maplac/StringLights/Electronics/doc_string_lights_revA/image_bottom.jpg

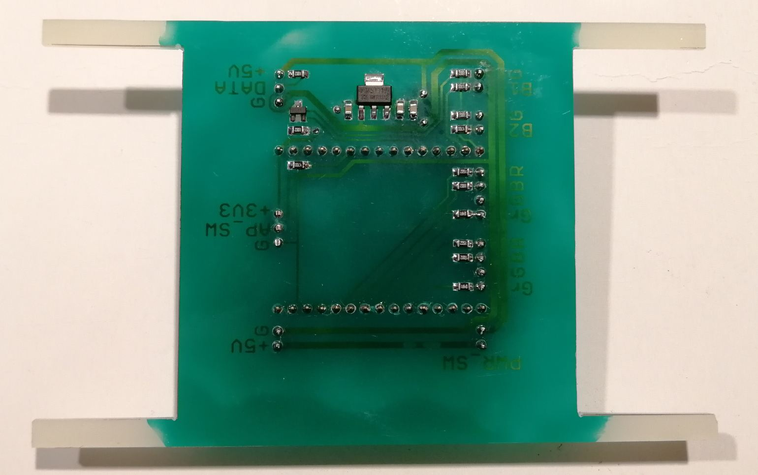
Electronics/doc_string_lights_revA/image_bottom.jpg
