maplac/StringLights/Electronics/doc_string_lights_revA/image_box_back.jpg

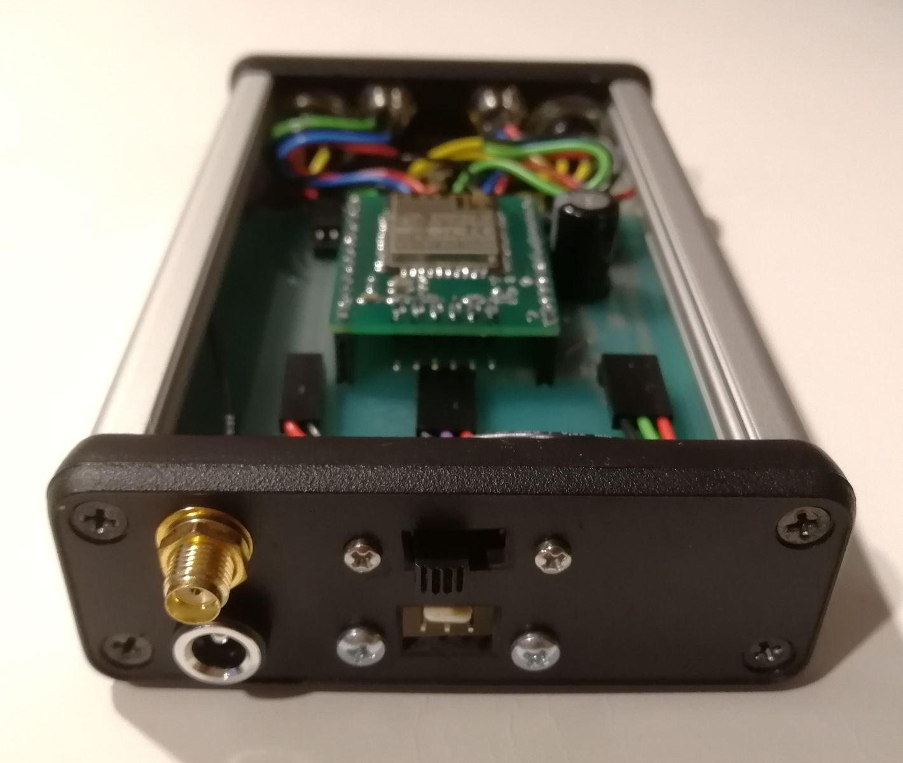
Electronics/doc_string_lights_revA/image_box_back.jpg
