maplac/StringLights/Electronics/doc_ESP32_adapter_revB/image_bottom.jpg

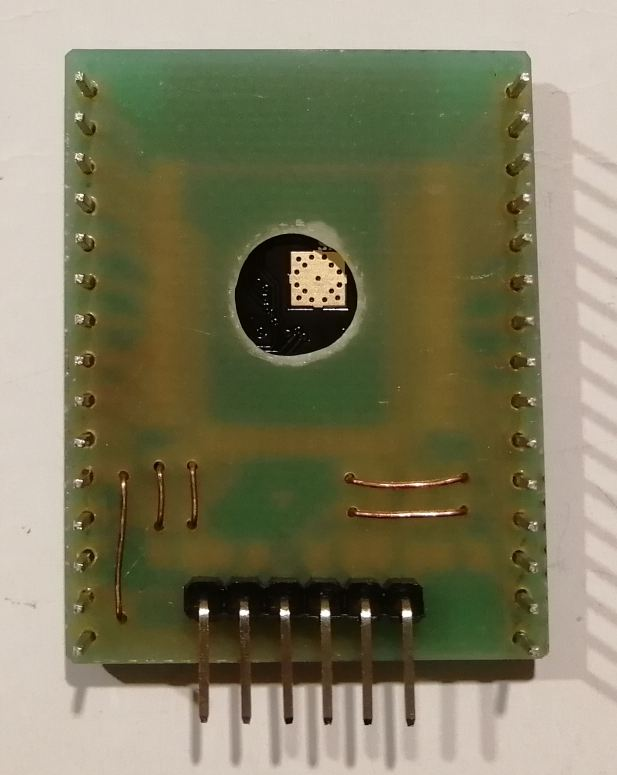
Electronics/doc_ESP32_adapter_revB/image_bottom.jpg
