maplac/StringLights/Electronics/doc_ESP32_adapter_revB/image_top.jpg

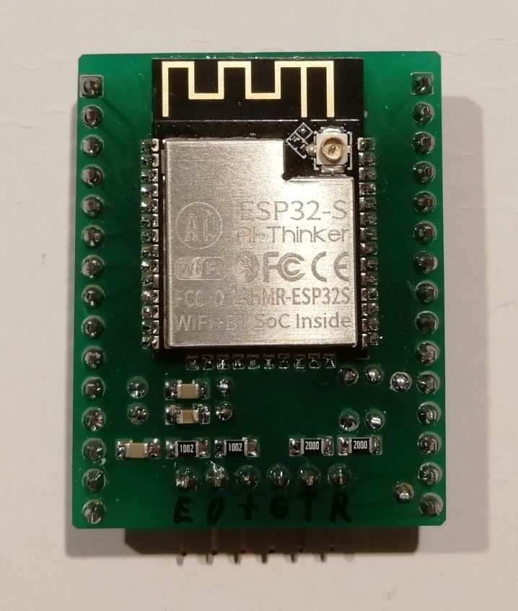
Electronics/doc_ESP32_adapter_revB/image_top.jpg
