maplac/StringLights/Electronics/doc_ESP32_programmer_revA/image_top.jpg

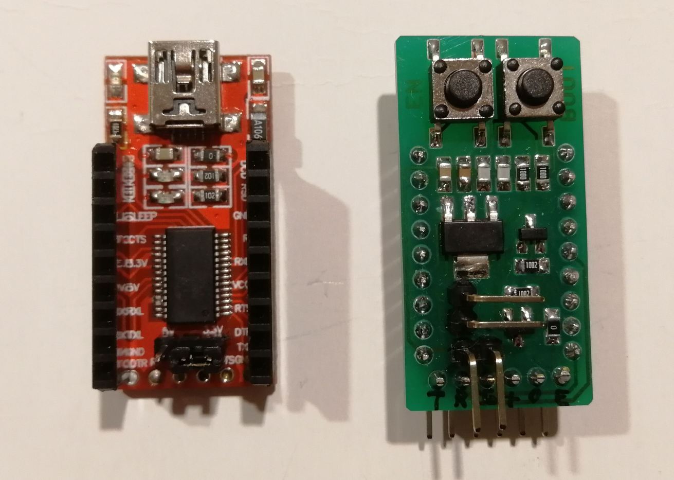
Electronics/doc_ESP32_programmer_revA/image_top.jpg
