maplac/StringLights/Electronics/doc_ESP32_programmer_revA/mask.png

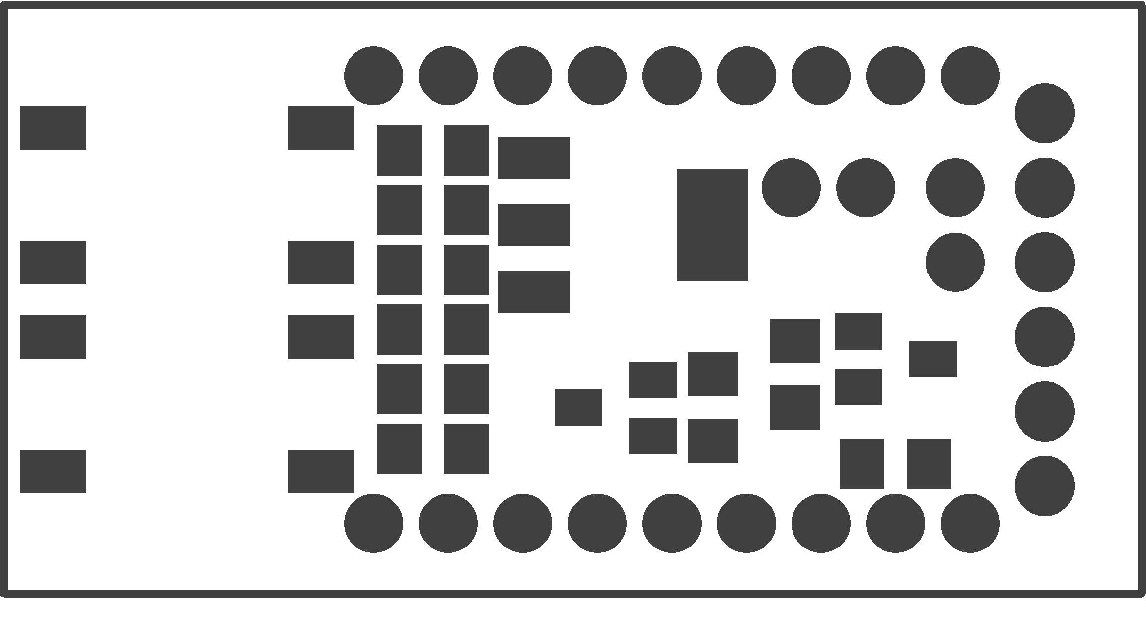
Electronics/doc_ESP32_programmer_revA/mask.png
