maplac/StringLights/Electronics/doc_ESP32_programmer_revA/names.png

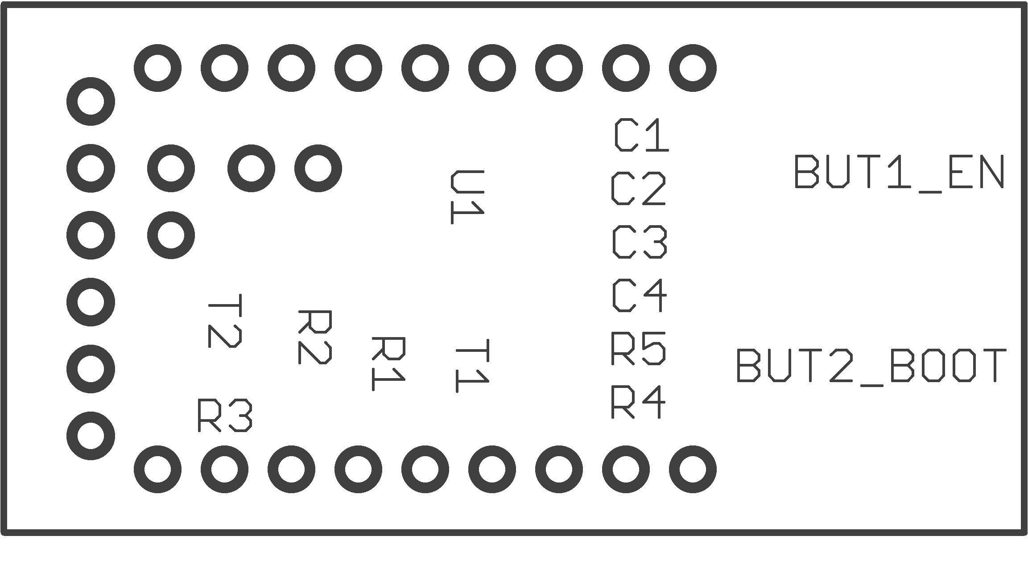
Electronics/doc_ESP32_programmer_revA/names.png
