maplac/StringLights/Electronics/doc_ESP32_programmer_revA/schematics.png

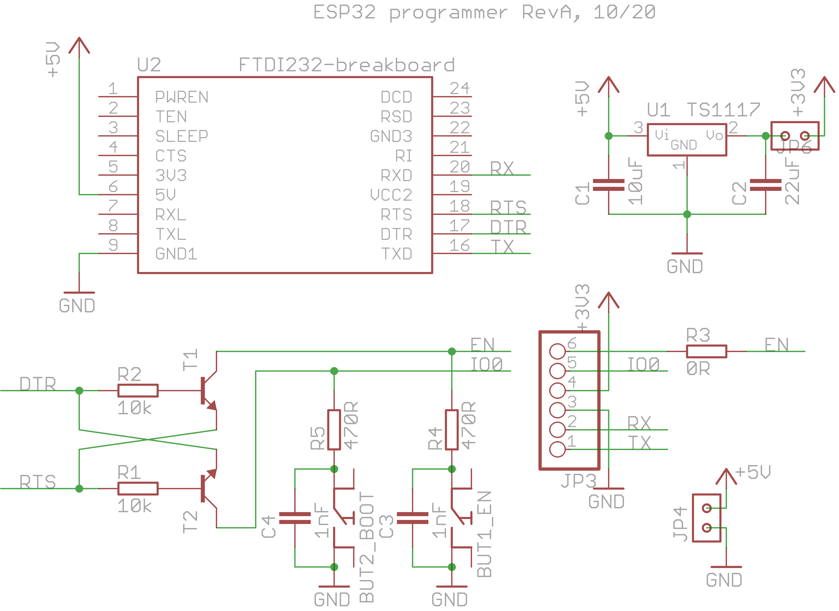
Electronics/doc_ESP32_programmer_revA/schematics.png
