maplac/StringLights/Electronics/doc_ESP32_programmer_revA/top.png

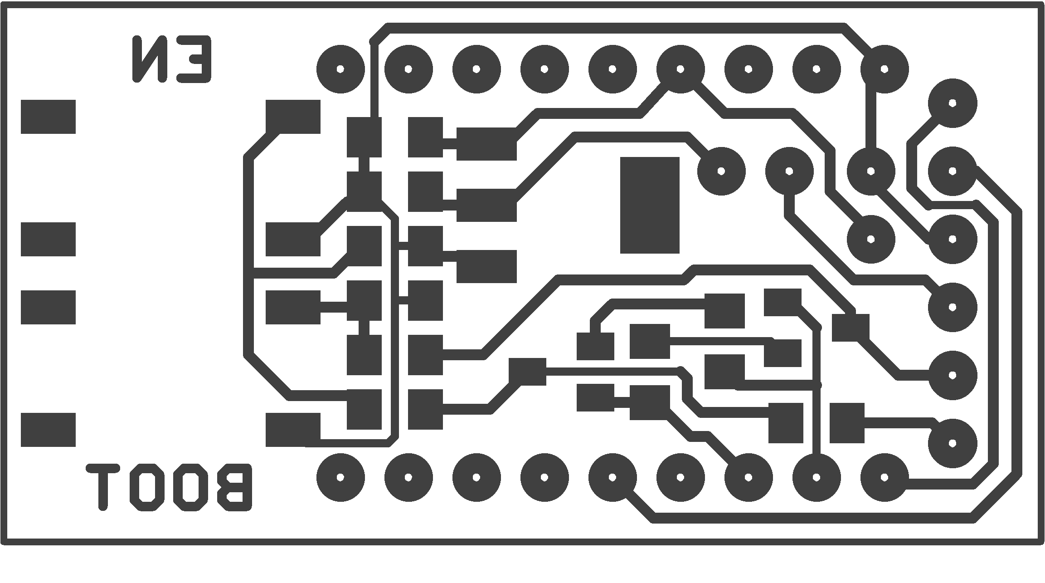
Electronics/doc_ESP32_programmer_revA/top.png
