maplac/StringLights/Electronics/doc_ESP32_programmer_revA/values.png

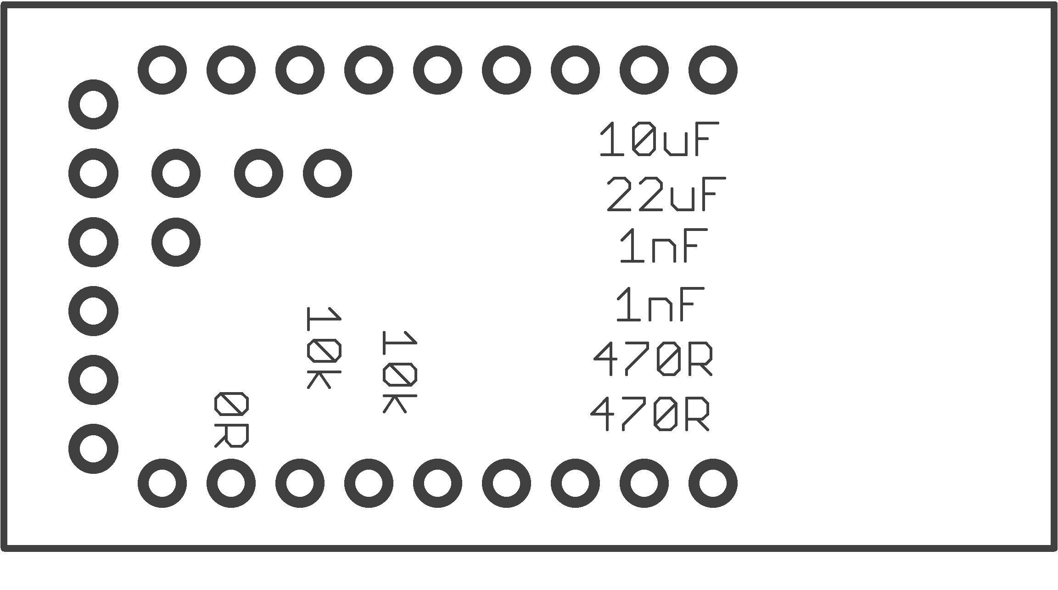
Electronics/doc_ESP32_programmer_revA/values.png
