maplac/StringLights/Electronics/doc_string_lights_revA/bottom.png

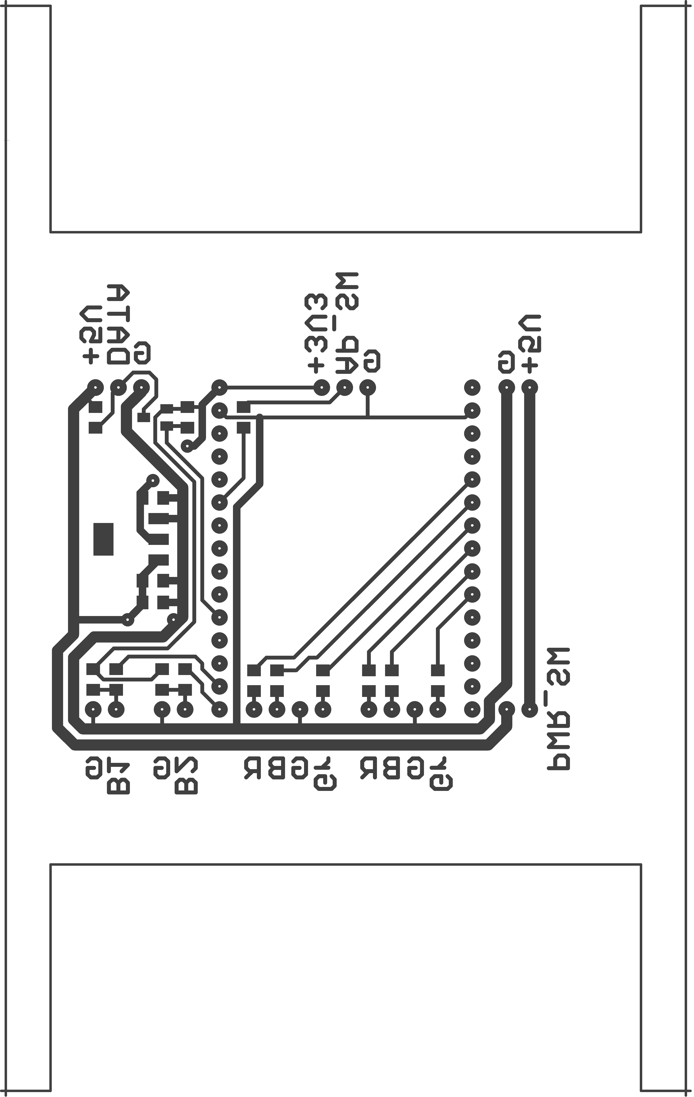
Electronics/doc_string_lights_revA/bottom.png
