maplac/StringLights/Electronics/doc_string_lights_revA/image_box_front.jpg

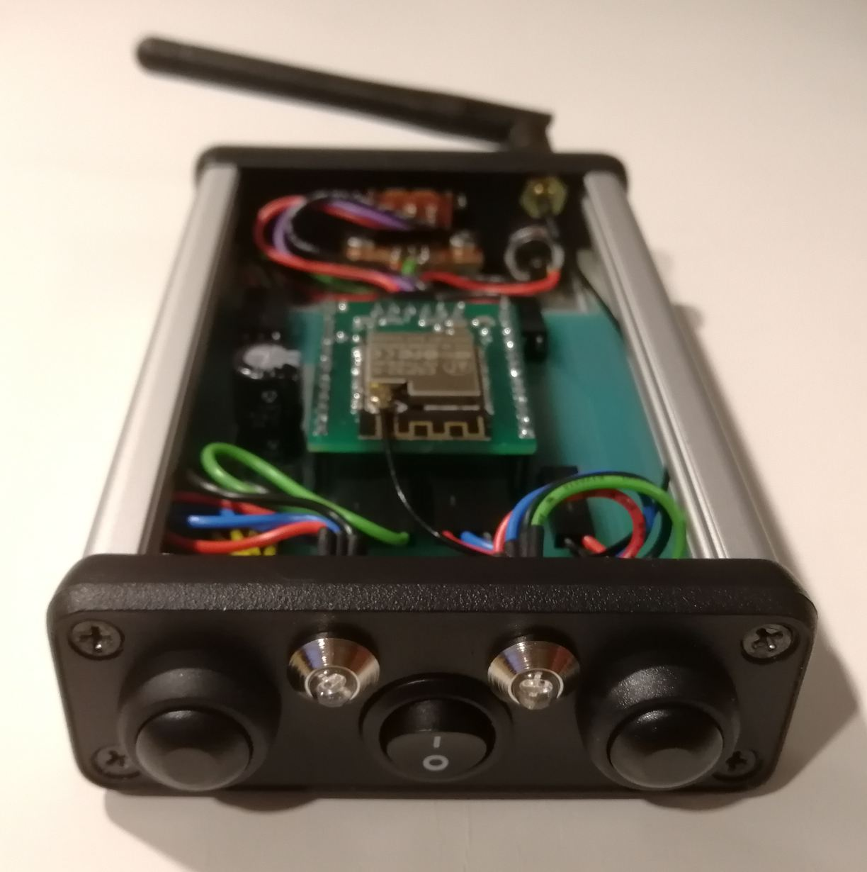
Electronics/doc_string_lights_revA/image_box_front.jpg
