maplac/StringLights/Electronics/doc_string_lights_revA/image_box_top.jpg

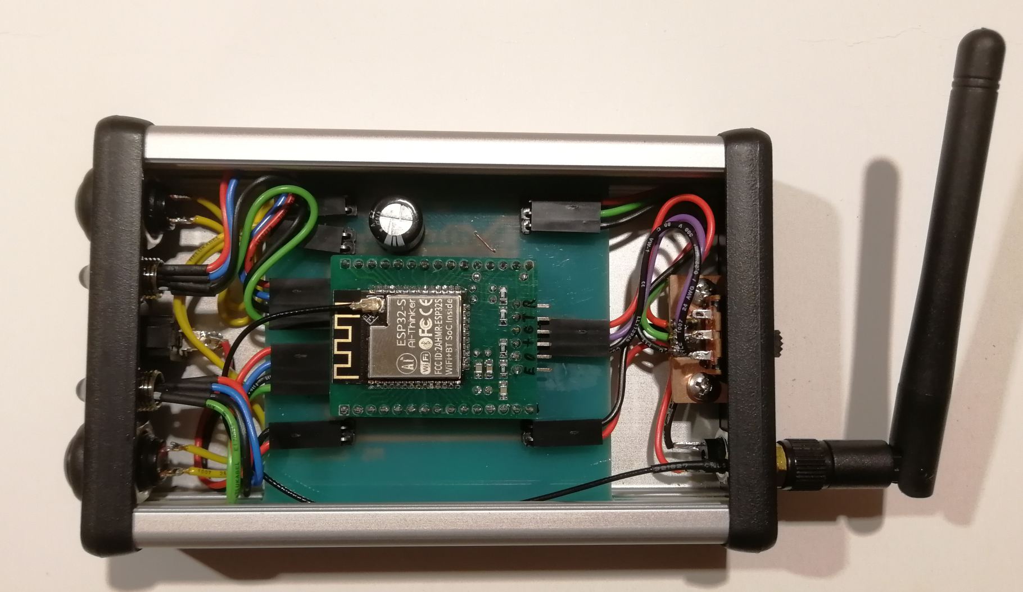
Electronics/doc_string_lights_revA/image_box_top.jpg
