maplac/StringLights/Electronics/doc_string_lights_revA/image_top.jpg

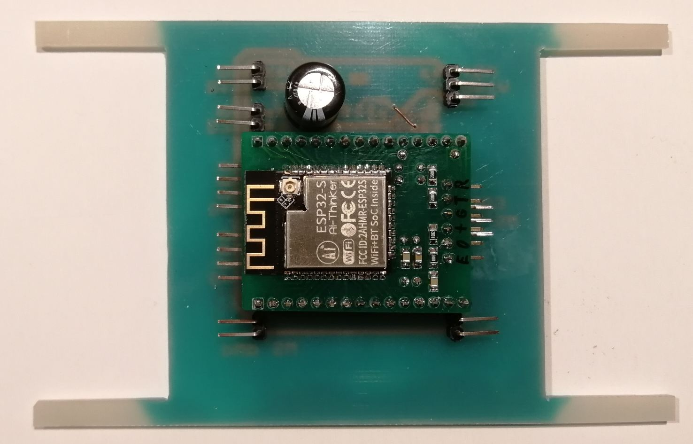
Electronics/doc_string_lights_revA/image_top.jpg
