maplac/StringLights/Electronics/doc_string_lights_revA/schematics.png

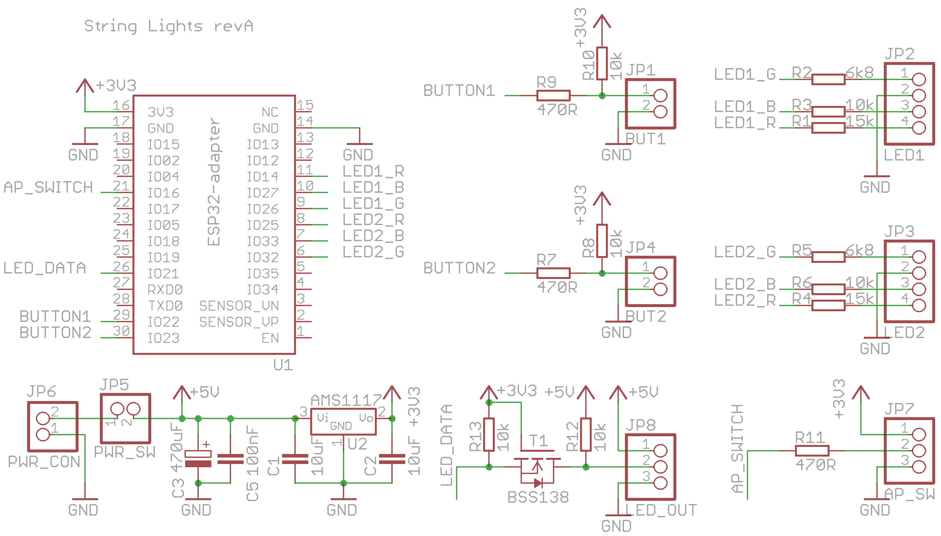
Electronics/doc_string_lights_revA/schematics.png
