maplac/StringLights/Electronics/doc_ESP32_programmer_revA/for_print.docx

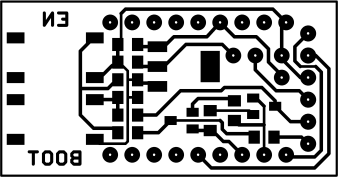
[picture p16: figure]
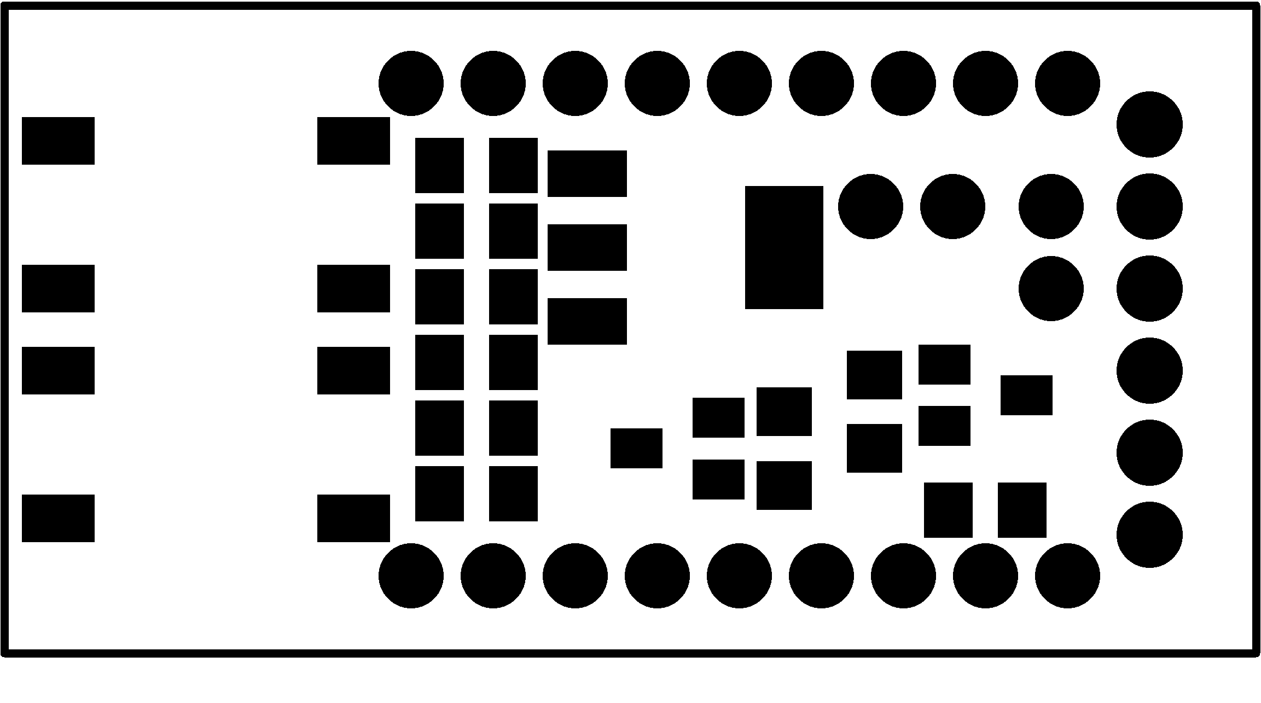
[picture p17: figure]
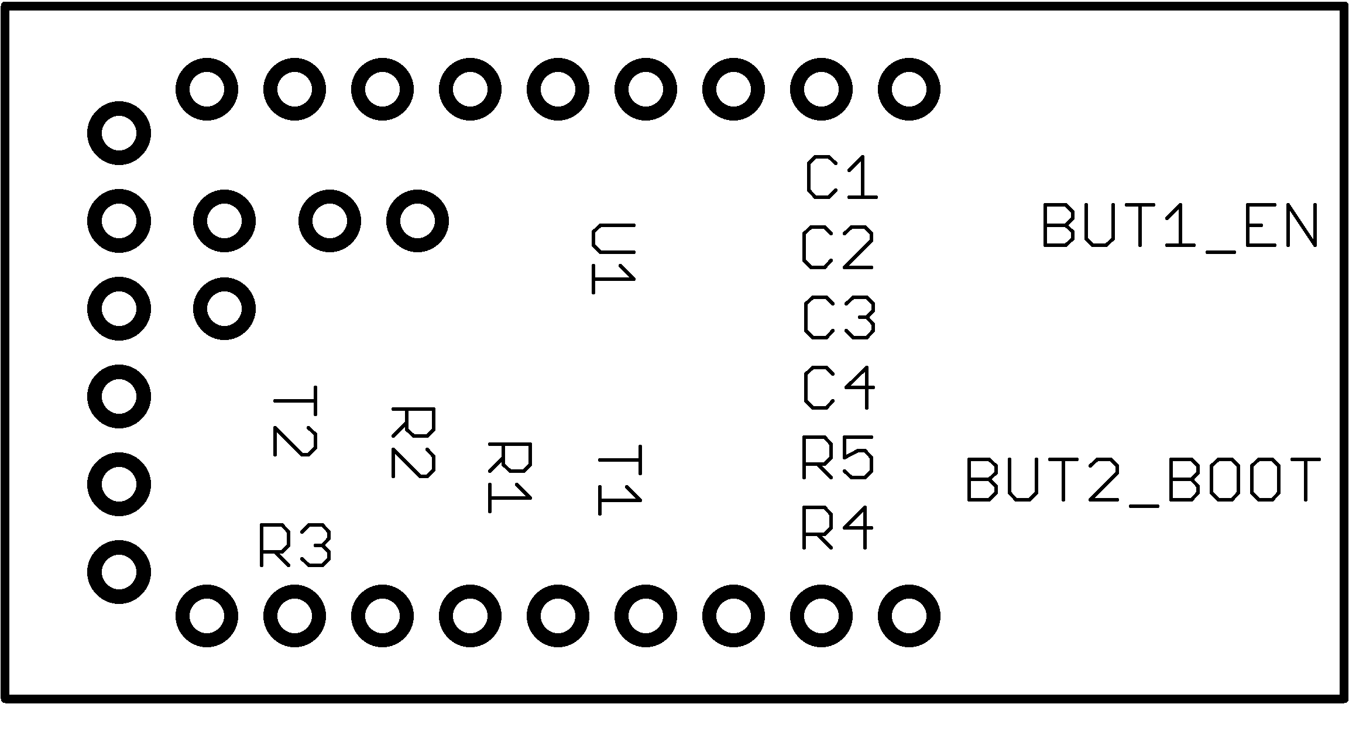
[picture p18: figure]
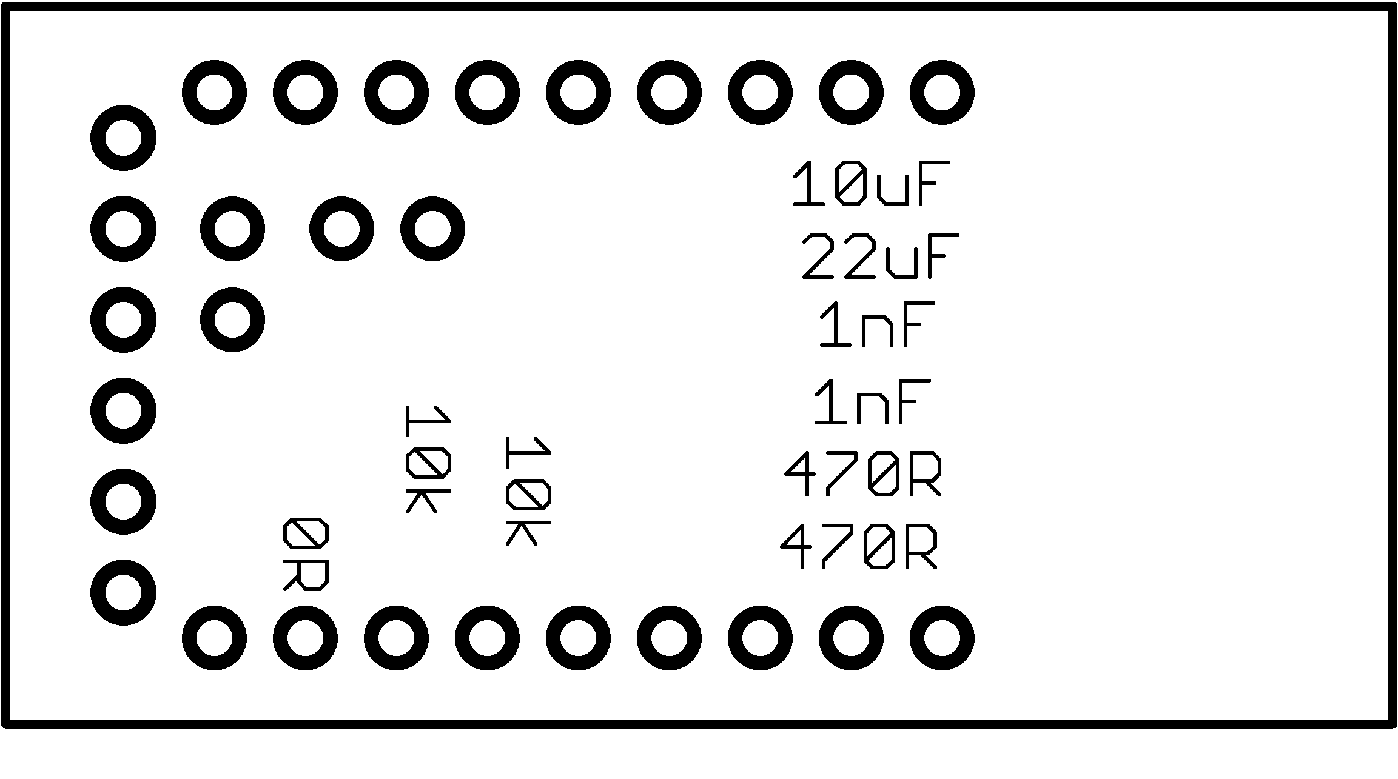
[picture p19: figure]
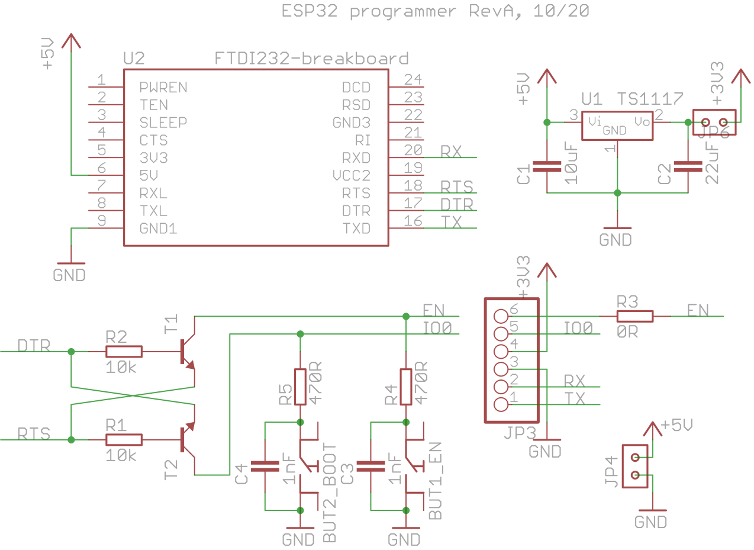
[picture p20: figure]
