maplac/StringLights/Electronics/doc_string_lights_revA/for_print.docx

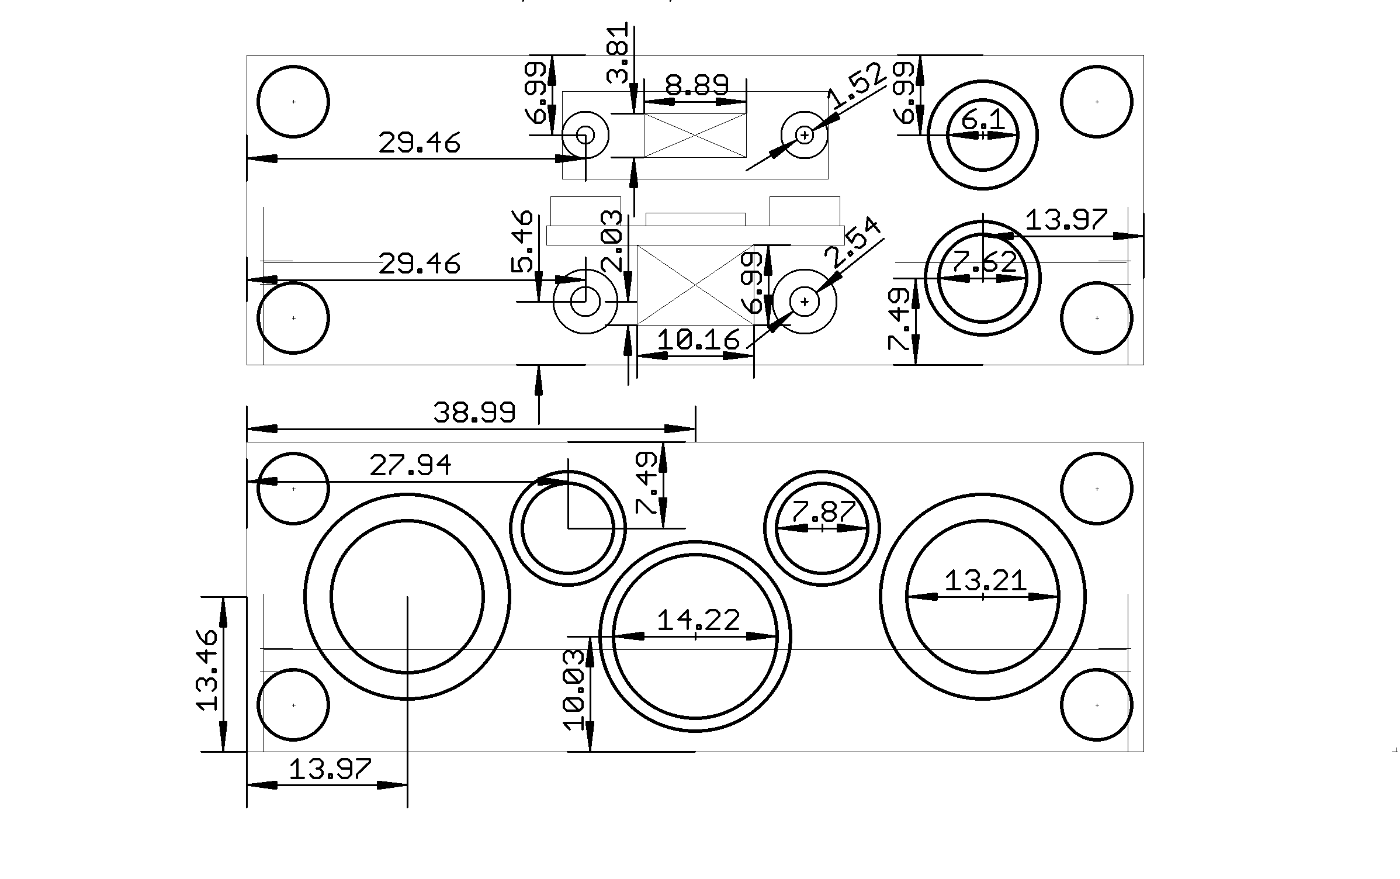
[picture p21: figure]
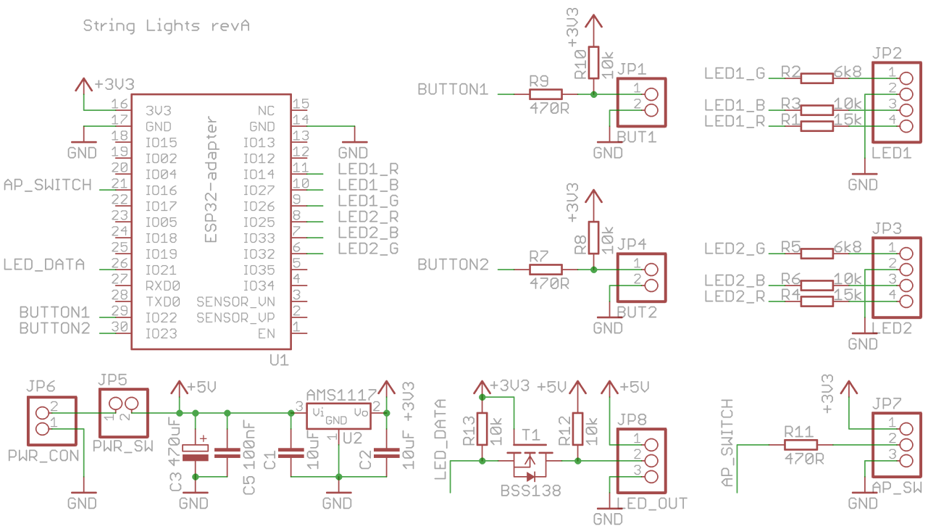
[picture p22: figure]
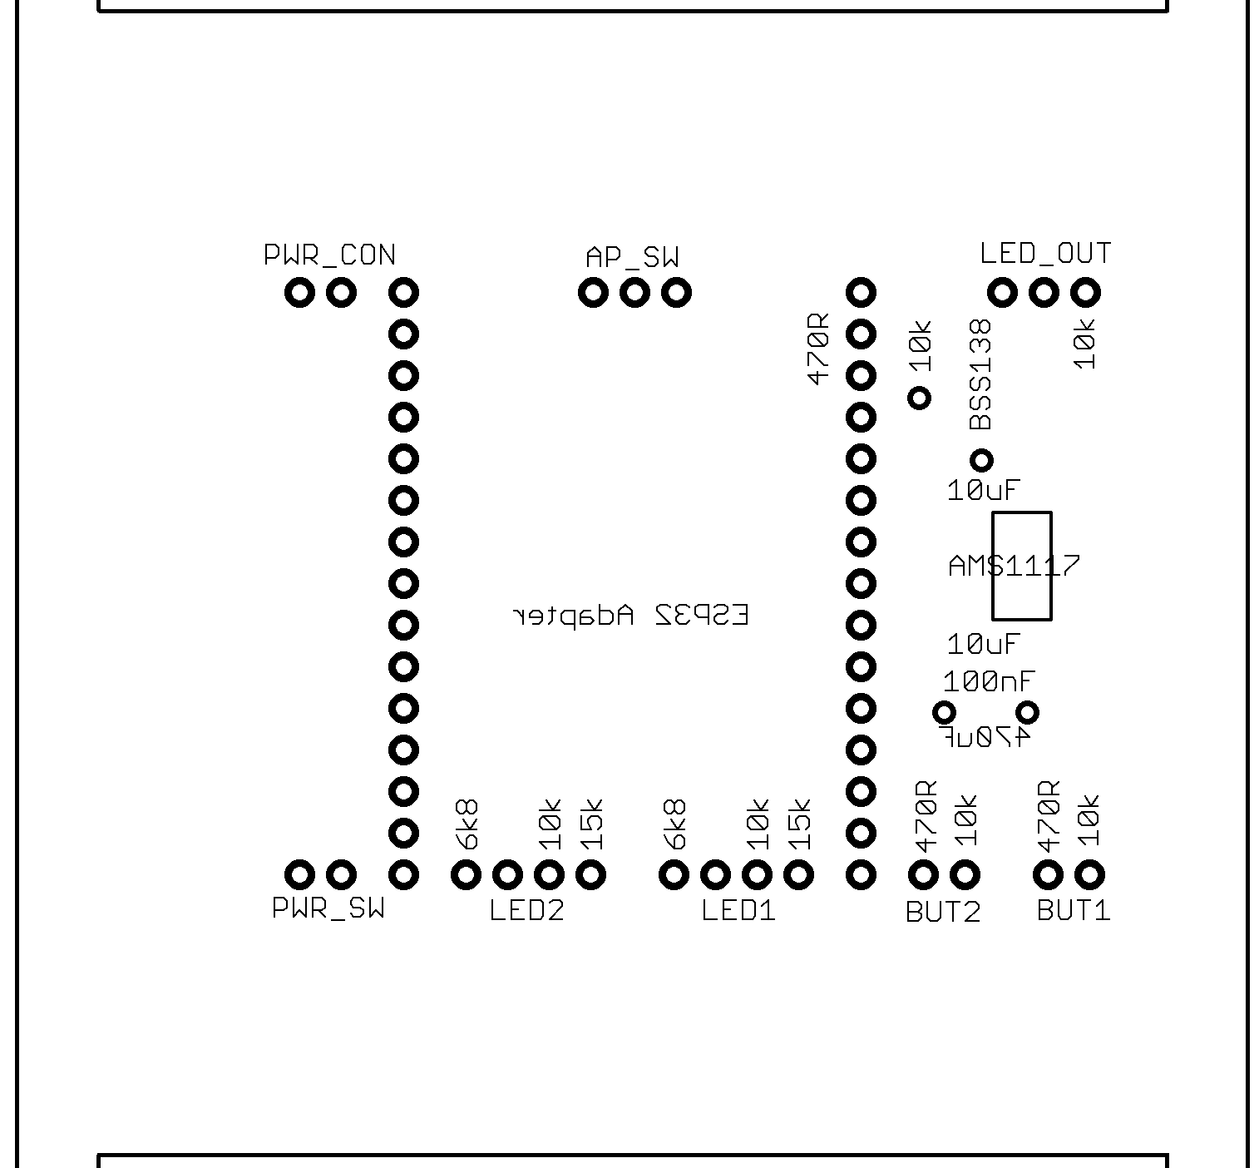
[picture p23: figure]
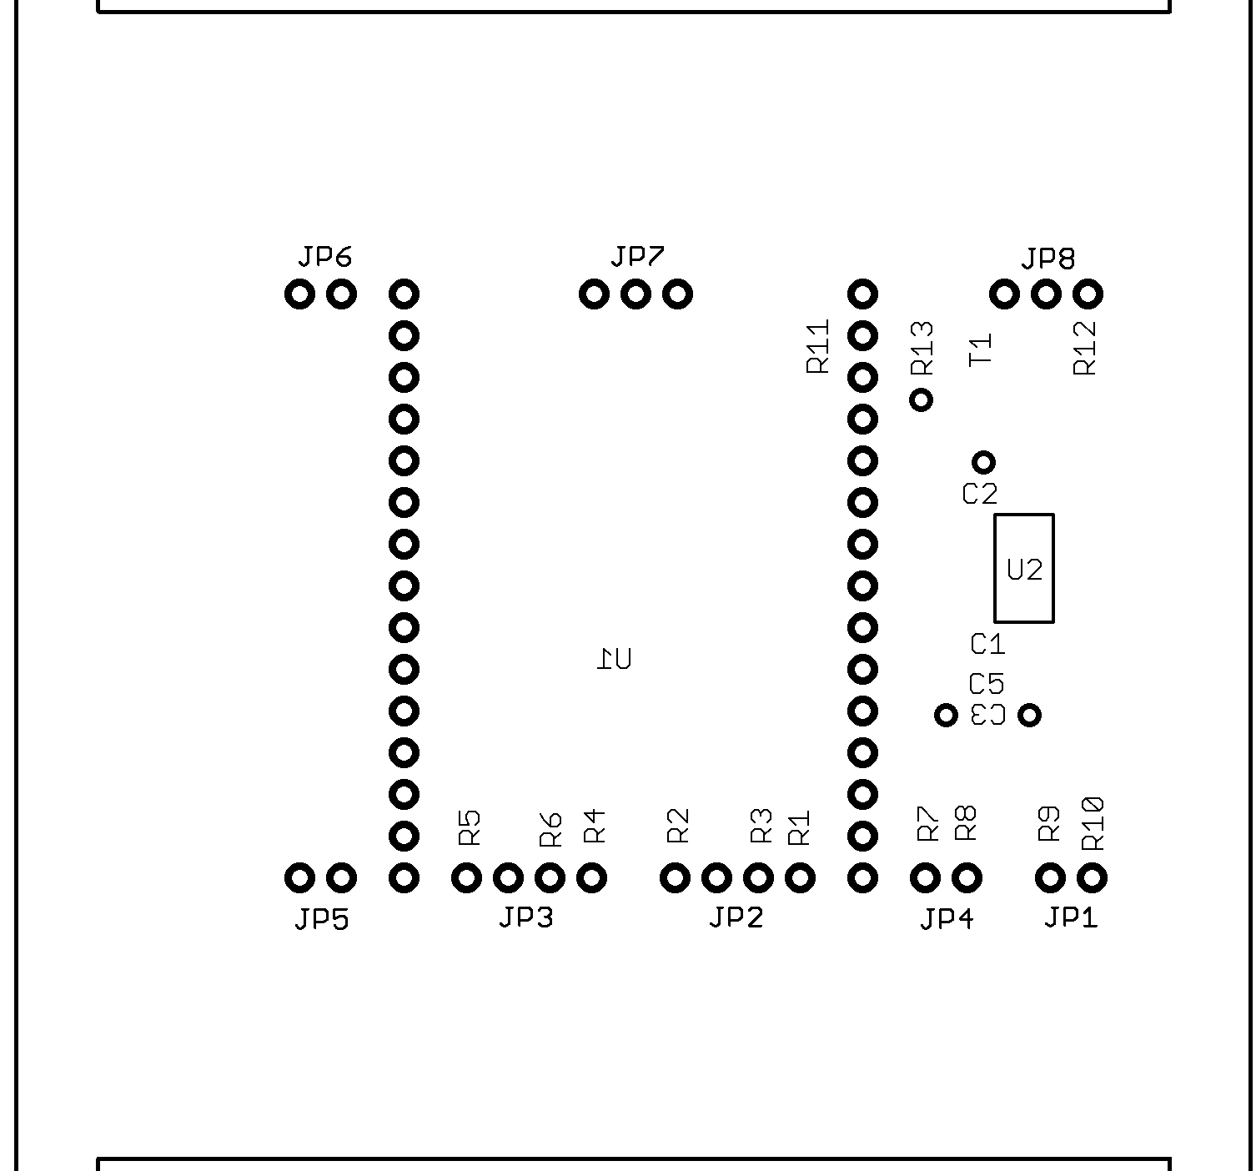
[picture p24: figure]
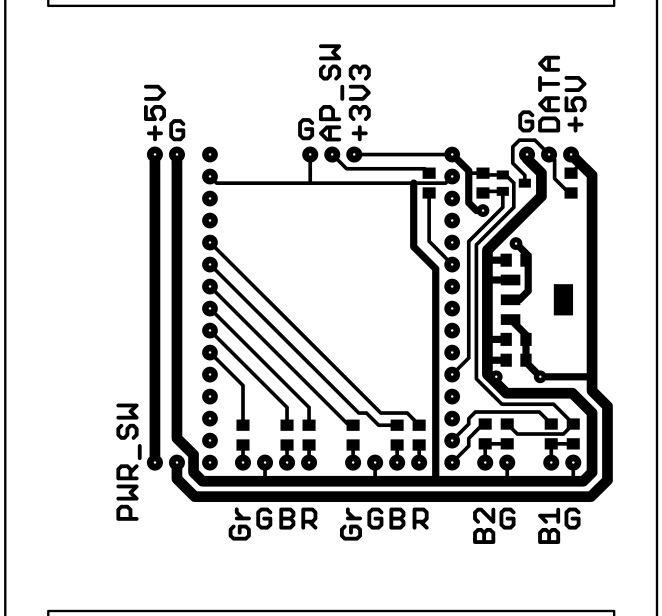
[picture p25: figure]
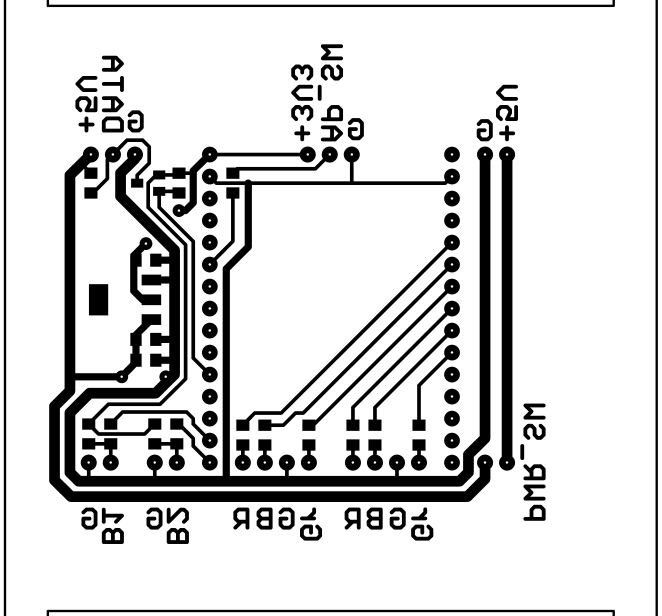
[picture p26: figure]
