maplac/StringLights/Electronics/doc_ESP32_adapter_revB/for_print.docx

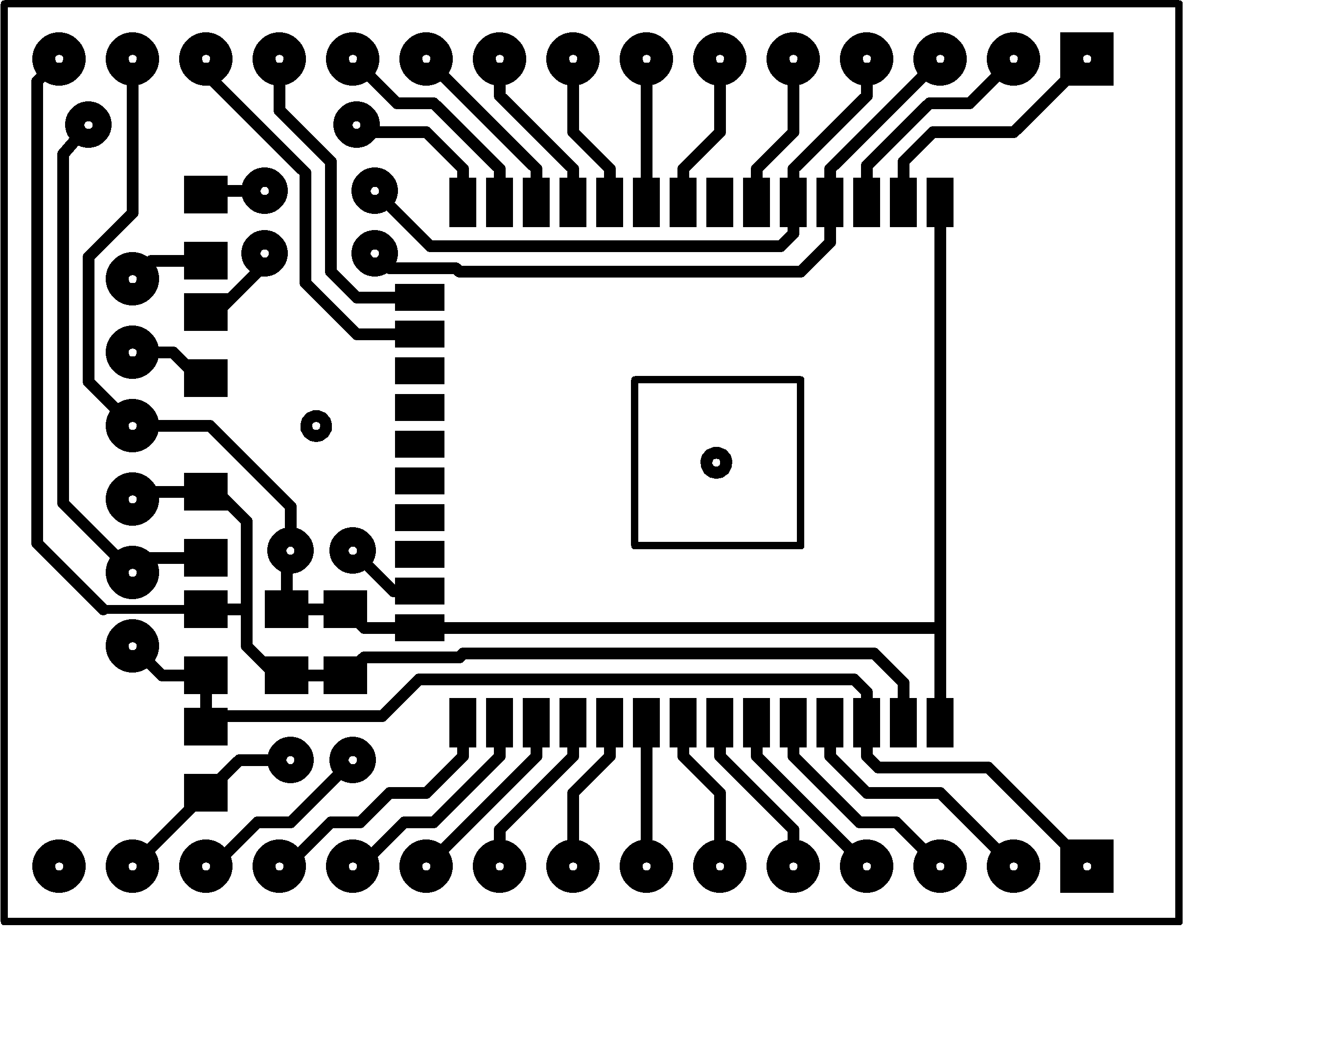
[picture p27: figure]
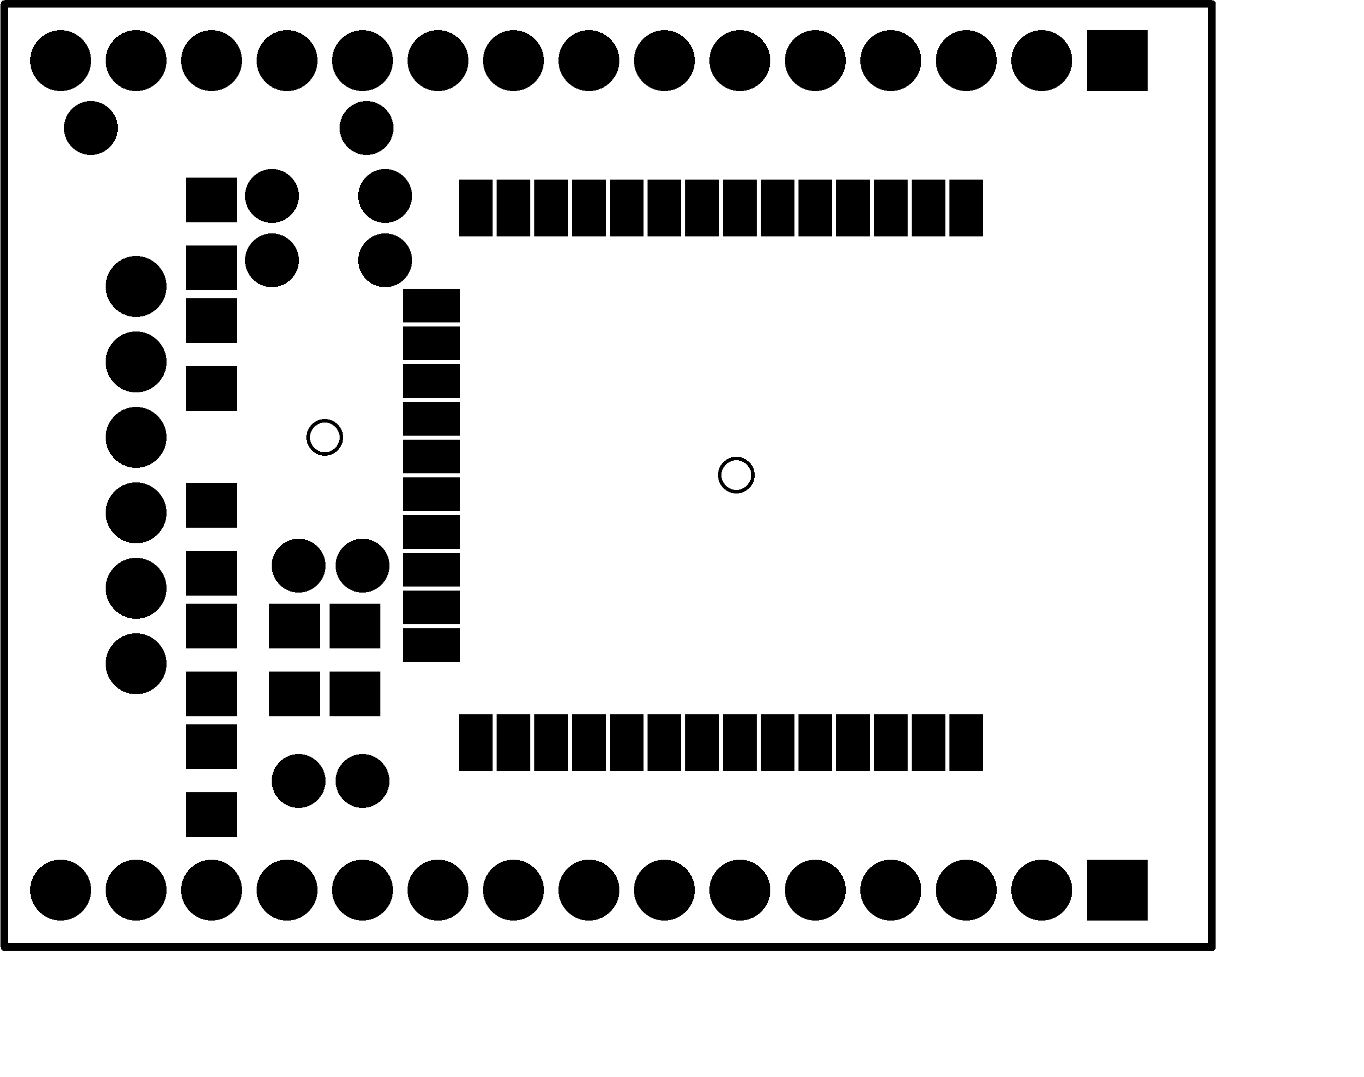
[picture p28: figure]
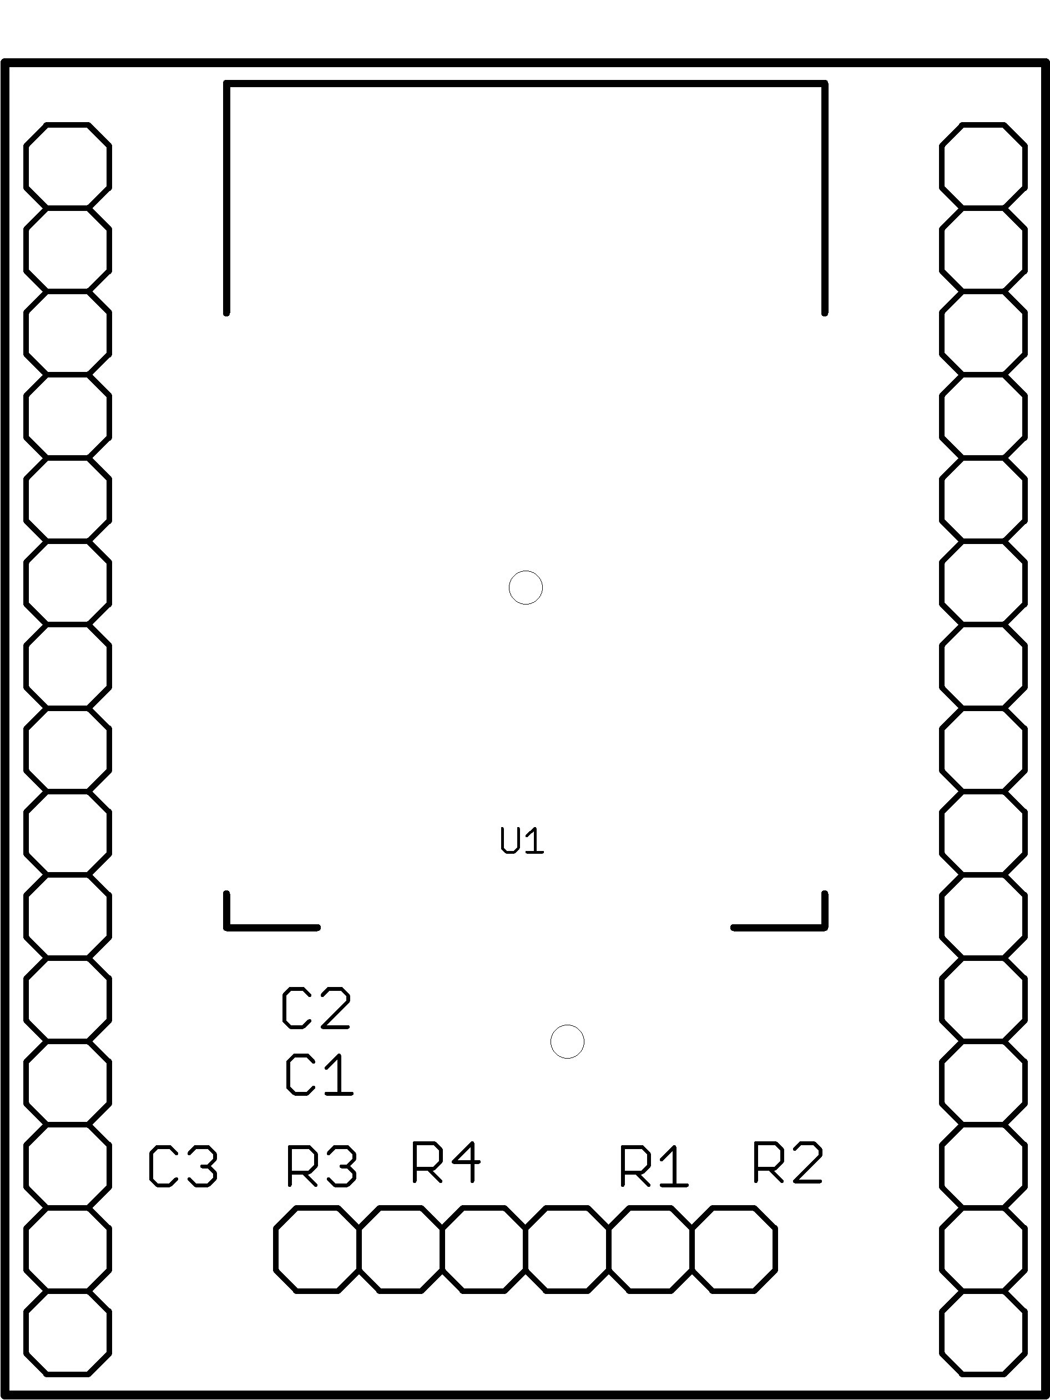
[picture p29: figure]
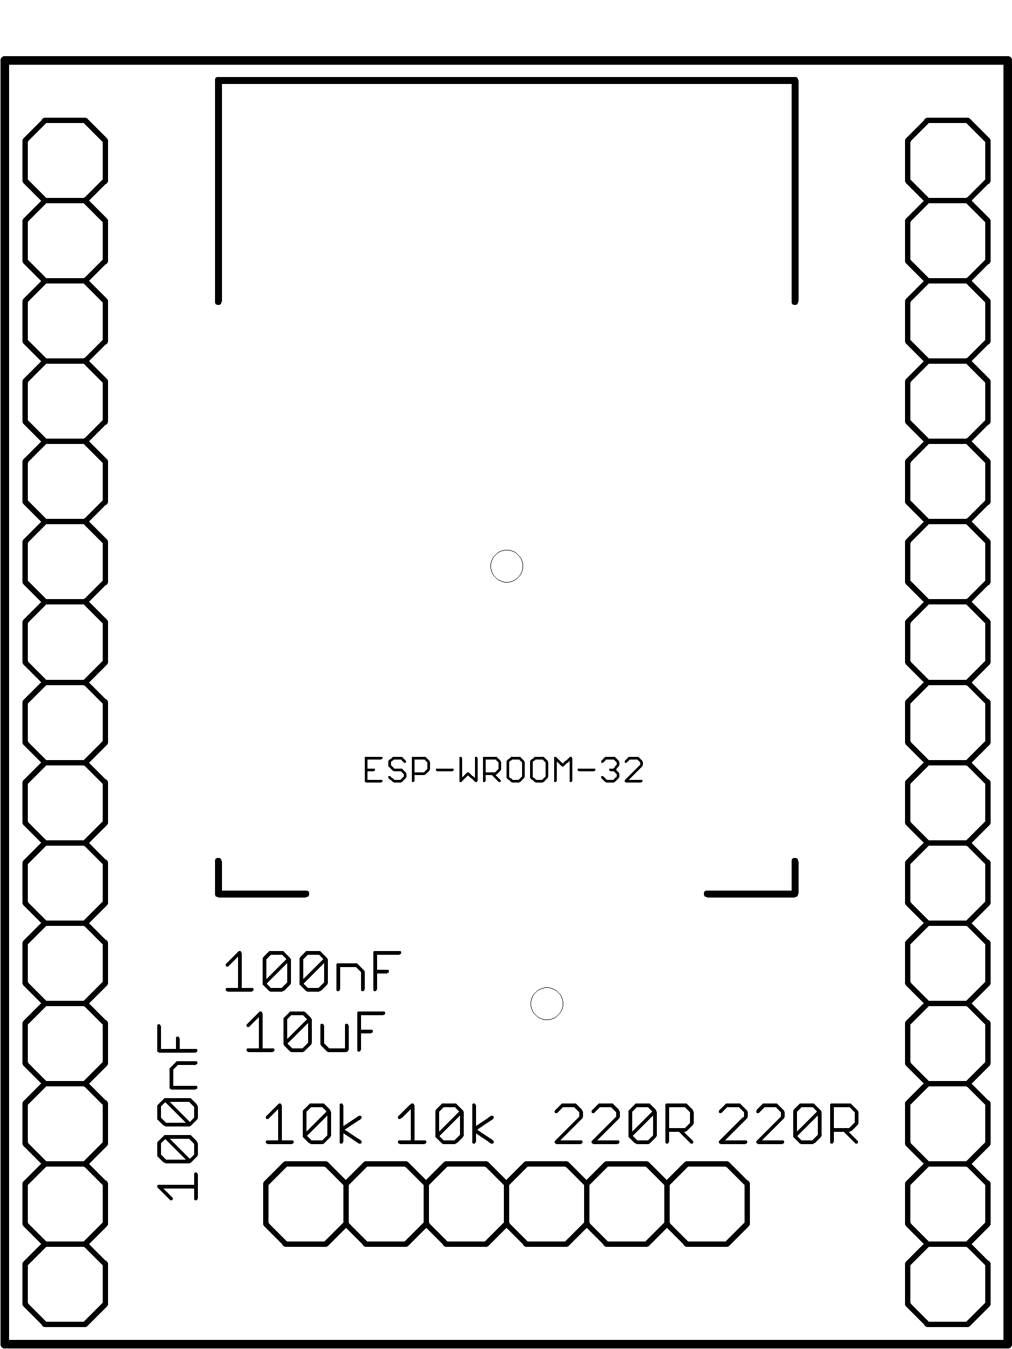
[picture p30: figure]
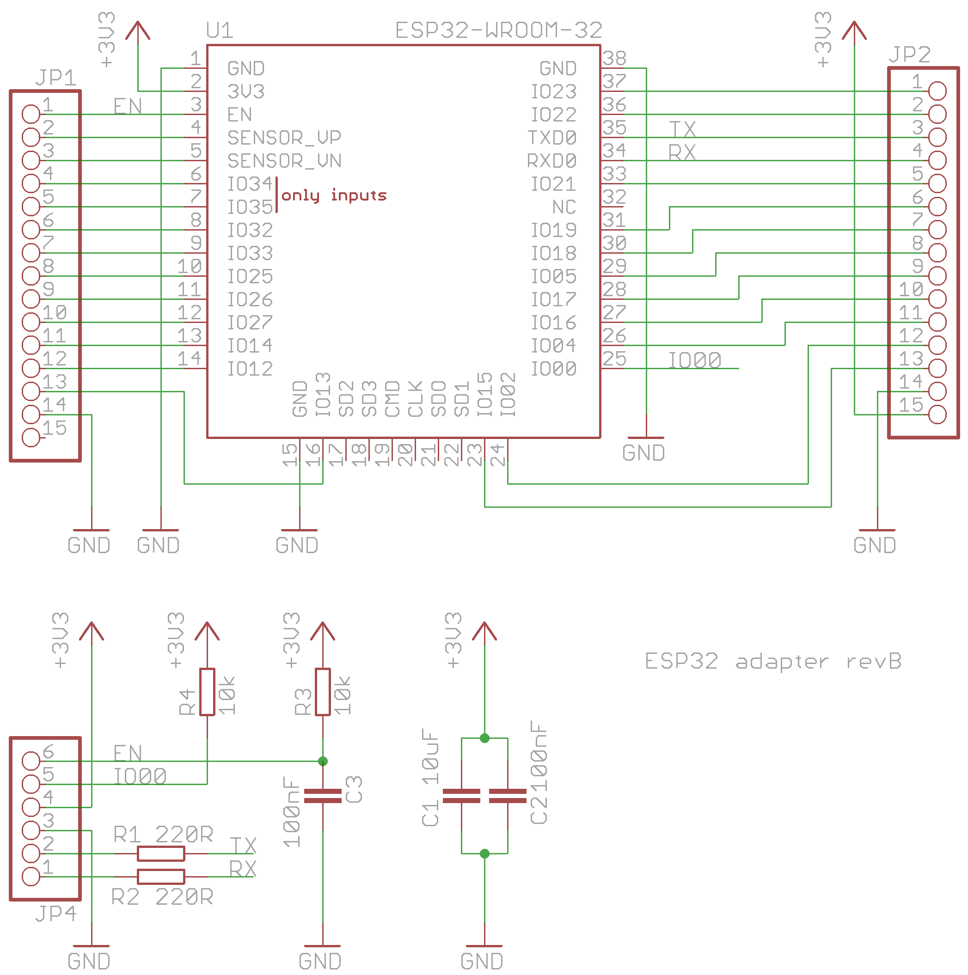
[picture p31: figure]
