maplac/StringLights/Electronics/doc_ESP32_programmer_revA/TODO.txt

Resistors R4 and R5 must be lower then 470 Ohm. 100 Ohm works fine.
