maplac/StringLights/TODO.txt

SW tlacitko na restart.

V modu soft-ap vsechny adresy presmerovat do modulu.

Na webu zobrazit informace o zarizeni - volna pamet, verze FW, sila WiFi signalu, posledni chybu, atp.

V multicolor vybirat index zadanim textu. Jako vyber stranek pri tisku.

Maska pro StringLightsRevA nema pady pro smd.

V multicolor se spatne formatuje skrolovani, kdyz je nastavenych hodne barev.

Otestovat obnoveni z vypadku wifi.
