maplac/StringLights/Electronics/esp32_programmer_revA.brd

## EAGLE design Electronics/esp32_programmer_revA.brd (2019-12-03)

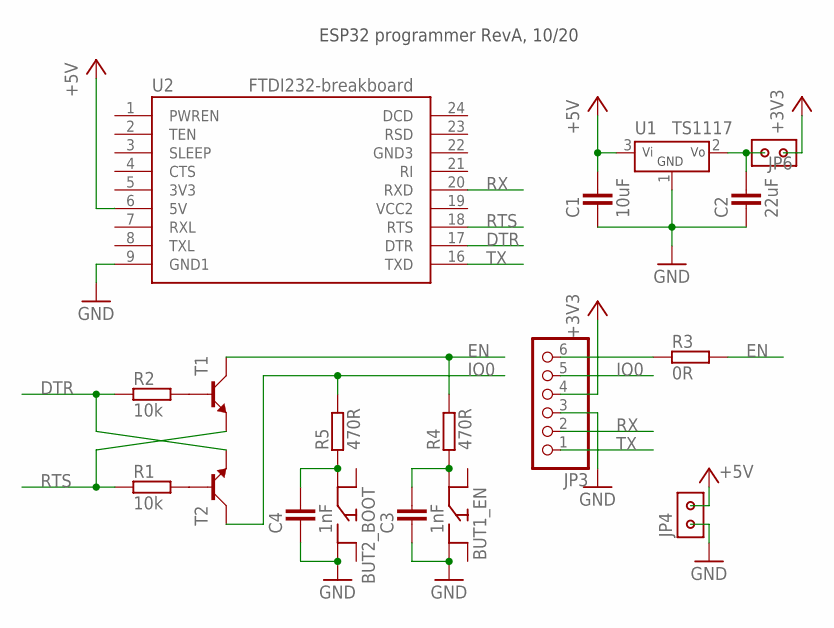
[picture p32: schematic esp32_programmer_revA.sch]

Parts:
BUT1_EN, BUT2_BOOT: BUTTON'SMD'; BUTTON_SMD
C1: 10uF; C0805
C2: 22uF; C0805
C3, C4: 1nF; C0805
JP3: PINHD-1X6; 1X06
JP4, JP6: PINHD-2X1
R1, R2: 10k; R0805
R3: 0R; R0805
R4, R5: 470R; R0805
T1, T2: TRAN_NPN'BC817'; SOT23
U1: TS1117; SOT223
U2: FTDI232-BREAKBOARD-SIMPLE; FTDI232-BRAKBOARD-SIMPLE

Connections:
3V3: U2.5 (3V3)
+3V3: JP3.4, JP6.2
+5V: C1.2, JP4.1, U1.3 (VIN), U2.6 (5V)
DTR: R2.1, T2.2 (E), U2.17 (DTR)
EN: R3.2, R4.2, T1.3 (C)
GND: BUT1_EN.3 (1), BUT2_BOOT.3 (1), C1.1, C2.1, C3.1, C4.1, JP3.3, JP4.2, U1.1 (GND), U2.9 (GND1)
GND3: U2.22 (GND3)
IO0: JP3.5, R5.2, T2.3 (C)
unnamed: R2.2, T1.1 (B)
unnamed: R1.2, T2.1 (B)
unnamed: BUT1_EN.2, C3.2, R4.1
unnamed: JP3.6, R3.1
unnamed: BUT2_BOOT.2, C4.2, R5.1
unnamed: C2.2, JP6.1, U1.2 (VOUT)
RTS: R1.1, T1.2 (E), U2.18 (RTS)
RX: JP3.2, U2.20 (RXD)
TX: JP3.1, U2.16 (TXD)
VCC2: U2.19 (VCC2)

Notes on the sheet:
ESP32 programmer RevA, 10/20

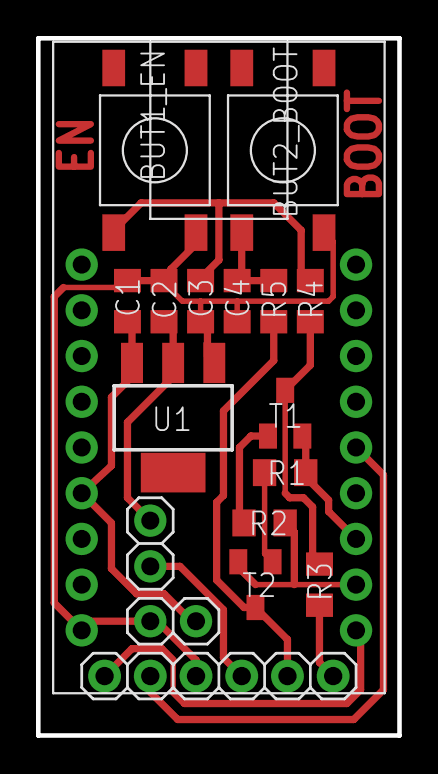
[picture p33: board esp32_programmer_revA.brd from above]

Board: 2 copper layers, 20.1 x 38.7 mm, 18 parts (0 on the bottom side), 15 nets.
