maplac/StringLights/Electronics/ESP32_adapter_revC.brd

## EAGLE design Electronics/ESP32_adapter_revC.brd (2019-12-03)

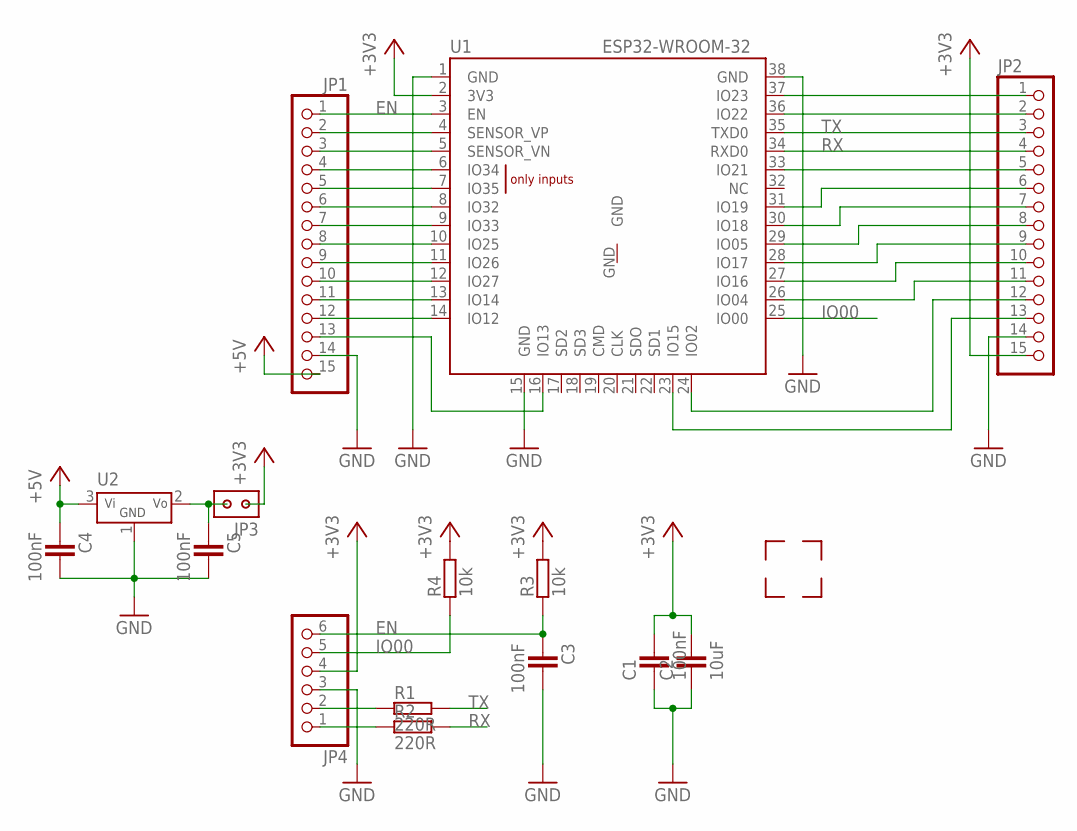
[picture p34: schematic ESP32_adapter_revC.sch]

Parts:
C1, C3, C4, C5: 100nF; C0805
C2: 10uF; C0805
JP1, JP2: PINHD-1X15; 1X15
JP3: PINHD-2X1
JP4: PINHD-1X6; 1X06
R1, R2: 220R; R0805
R3, R4: 10k; R0805
U1: ESP-WROOM-32
U2: V_STAB'TS1117'; SOT223
U$1, U$2, U$3, U$4: CORNER

Connections:
+3V3: C1.2, C2.2, JP2.15, JP3.2, JP4.4, R3.2, R4.2, U1.2 (3V3)
+5V: C4.1, JP1.15, U2.3 (VIN)
EN: C3.1, JP1.1, JP4.6, R3.1, U1.3 (EN)
GND: C1.1, C2.1, C3.2, C4.2, C5.2, JP1.14, JP2.14, JP4.3, U1.1 (GND), U1.15 (GND), U1.38 (GND), U2.1 (GND)
IO00: JP4.5, R4.1, U1.25 (IO00)
unnamed: JP4.1, R2.1
unnamed: JP4.2, R1.1
unnamed: JP1.2, U1.4 (SENSOR_VP)
unnamed: JP1.3, U1.5 (SENSOR_VN)
unnamed: JP1.4, U1.6 (IO34)
unnamed: JP1.5, U1.7 (IO35)
unnamed: JP1.6, U1.8 (IO32)
unnamed: JP1.7, U1.9 (IO33)
unnamed: JP1.8, U1.10 (IO25)
unnamed: JP1.9, U1.11 (IO26)
unnamed: JP1.10, U1.12 (IO27)
unnamed: JP1.11, U1.13 (IO14)
unnamed: JP1.12, U1.14 (IO12)
unnamed: C5.1, JP3.1, U2.2 (VOUT)
unnamed: JP2.1, U1.37 (IO23)
unnamed: JP2.2, U1.36 (IO22)
unnamed: JP2.5, U1.33 (IO21)
unnamed: JP2.6, U1.31 (IO19)
unnamed: JP2.7, U1.30 (IO18)
unnamed: JP2.8, U1.29 (IO05)
unnamed: JP2.9, U1.28 (IO17)
unnamed: JP2.10, U1.27 (IO16)
unnamed: JP2.11, U1.26 (IO04)
unnamed: JP2.12, U1.24 (IO02)
unnamed: JP2.13, U1.23 (IO15)
unnamed: JP1.13, U1.16 (IO13)
RX: JP2.4, R2.2, U1.34 (RXD0)
TX: JP2.3, R1.2, U1.35 (TXD0)

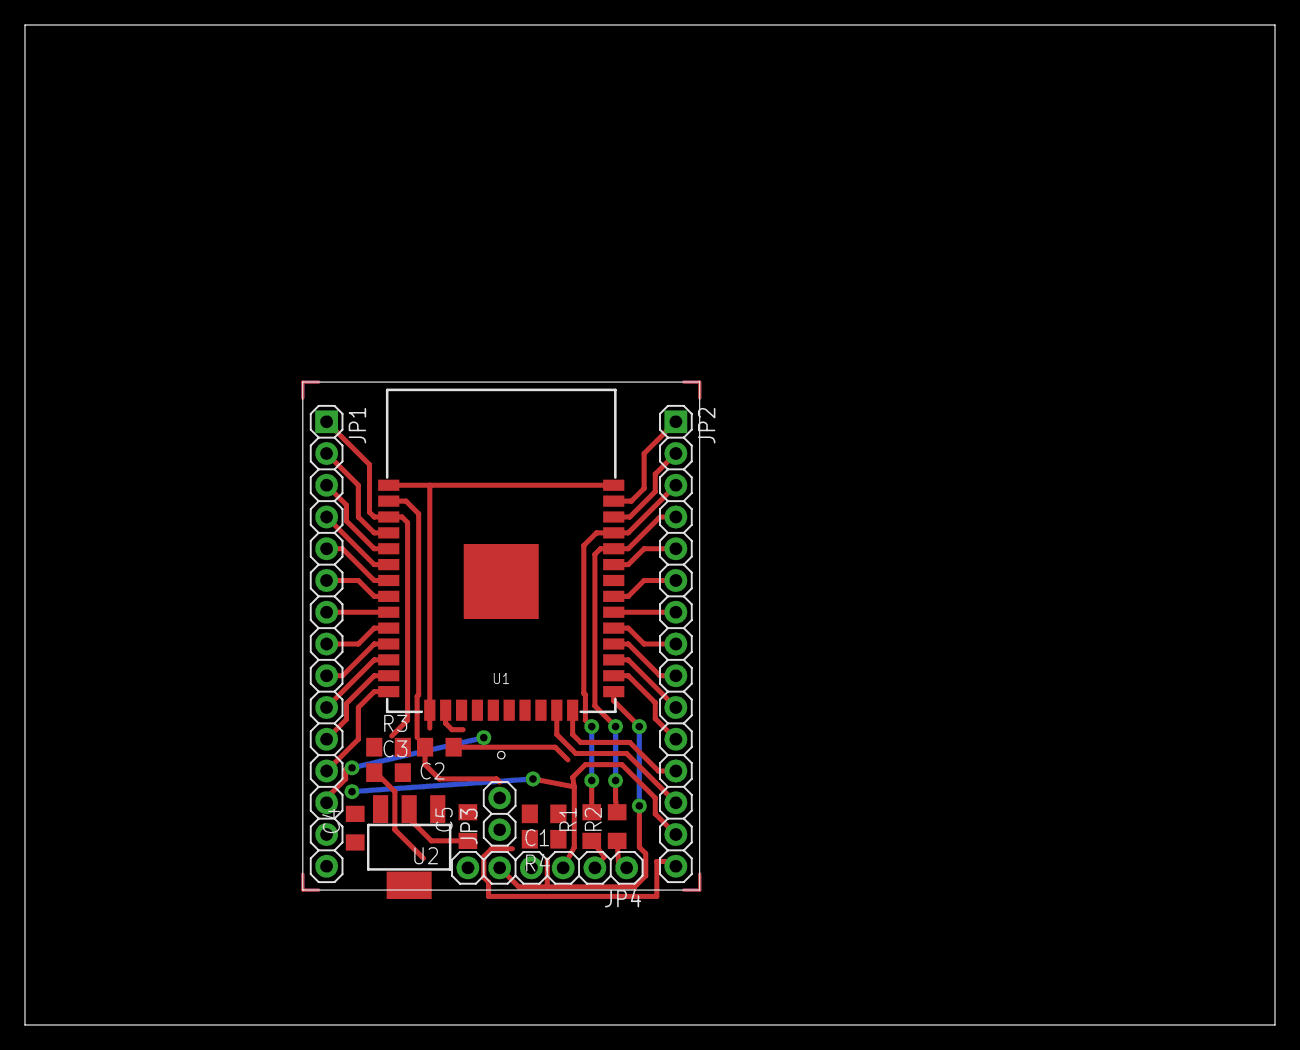
[picture p35: board ESP32_adapter_revC.brd from above]

Board: 2 copper layers, 100.0 x 80.0 mm, 19 parts (0 on the bottom side), 33 nets.
