maplac/StringLights/Electronics/string_lights_revA.brd

## EAGLE design Electronics/string_lights_revA.brd (2019-12-03)

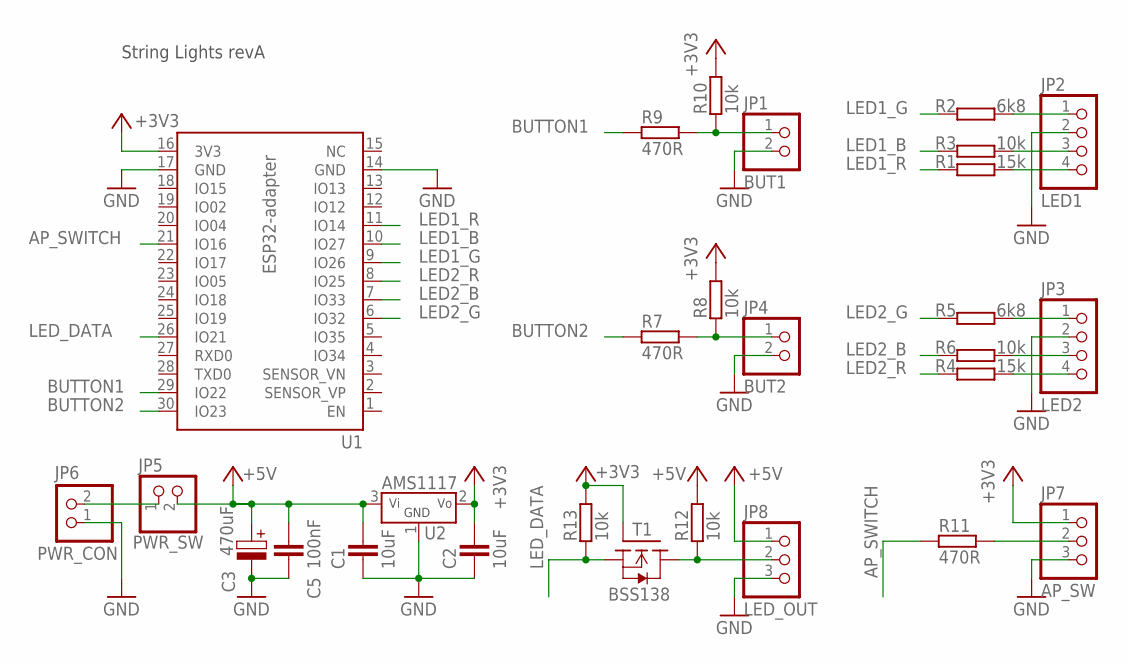
[picture p36: schematic string_lights_revA.sch]

Parts:
C1, C2: 10uF; C0805
C3: 470uF; ELYT-10MM
C5: 100nF; C0805
JP1: BUT1; 1X02/90
JP2: LED1; 1X04/90
JP3: LED2; 1X04/90
JP4: BUT2; 1X02/90
JP5: PWR_SW; 1X02/90
JP6: PWR_CON; 1X02/90
JP7: AP_SW; 1X03/90
JP8: LED_OUT; 1X03/90
R1, R4: 15k; R0805
R2, R5: 6k8; R0805
R3, R6, R8, R10, R12, R13: 10k; R0805
R7, R9, R11: 470R; R0805
T1: BSS138; SOT23
U1: ESP32-ADAPTER
U2: AMS1117; SOT223

Connections:
+3V3: C2.2, JP7.1, R8.2, R10.2, R13.2, T1.1 (G), U1.16 (3V3), U2.2 (VOUT)
+5V: C1.2, C3.P (POS), C5.2, JP5.2, JP8.1, R12.2, U2.3 (VIN)
AP_SWITCH: R11.1, U1.21 (IO16)
BUTTON1: R9.1, U1.29 (IO22)
BUTTON2: R7.1, U1.30 (IO23)
GND: C1.1, C2.1, C3.N (NEG), C5.1, JP1.2, JP2.2, JP3.2, JP4.2, JP6.1, JP7.3, JP8.3, U1.14 (GND), U1.17 (GND), U2.1 (GND)
LED1_B: R3.1, U1.10 (IO27)
LED1_G: R2.1, U1.9 (IO26)
LED1_R: R1.1, U1.11 (IO14)
LED2_B: R6.1, U1.7 (IO33)
LED2_G: R5.1, U1.6 (IO32)
LED2_R: R4.1, U1.8 (IO25)
LED_DATA: R13.1, T1.2 (S), U1.26 (IO21)
unnamed: JP5.1, JP6.2
unnamed: JP2.4, R1.2
unnamed: JP2.3, R3.2
unnamed: JP2.1, R2.2
unnamed: JP3.1, R5.2
unnamed: JP3.3, R6.2
unnamed: JP3.4, R4.2
unnamed: JP4.1, R7.2, R8.1
unnamed: JP1.1, R9.2, R10.1
unnamed: JP7.2, R11.2
unnamed: JP8.2, R12.1, T1.3 (D)

Notes on the sheet:
String Lights revA

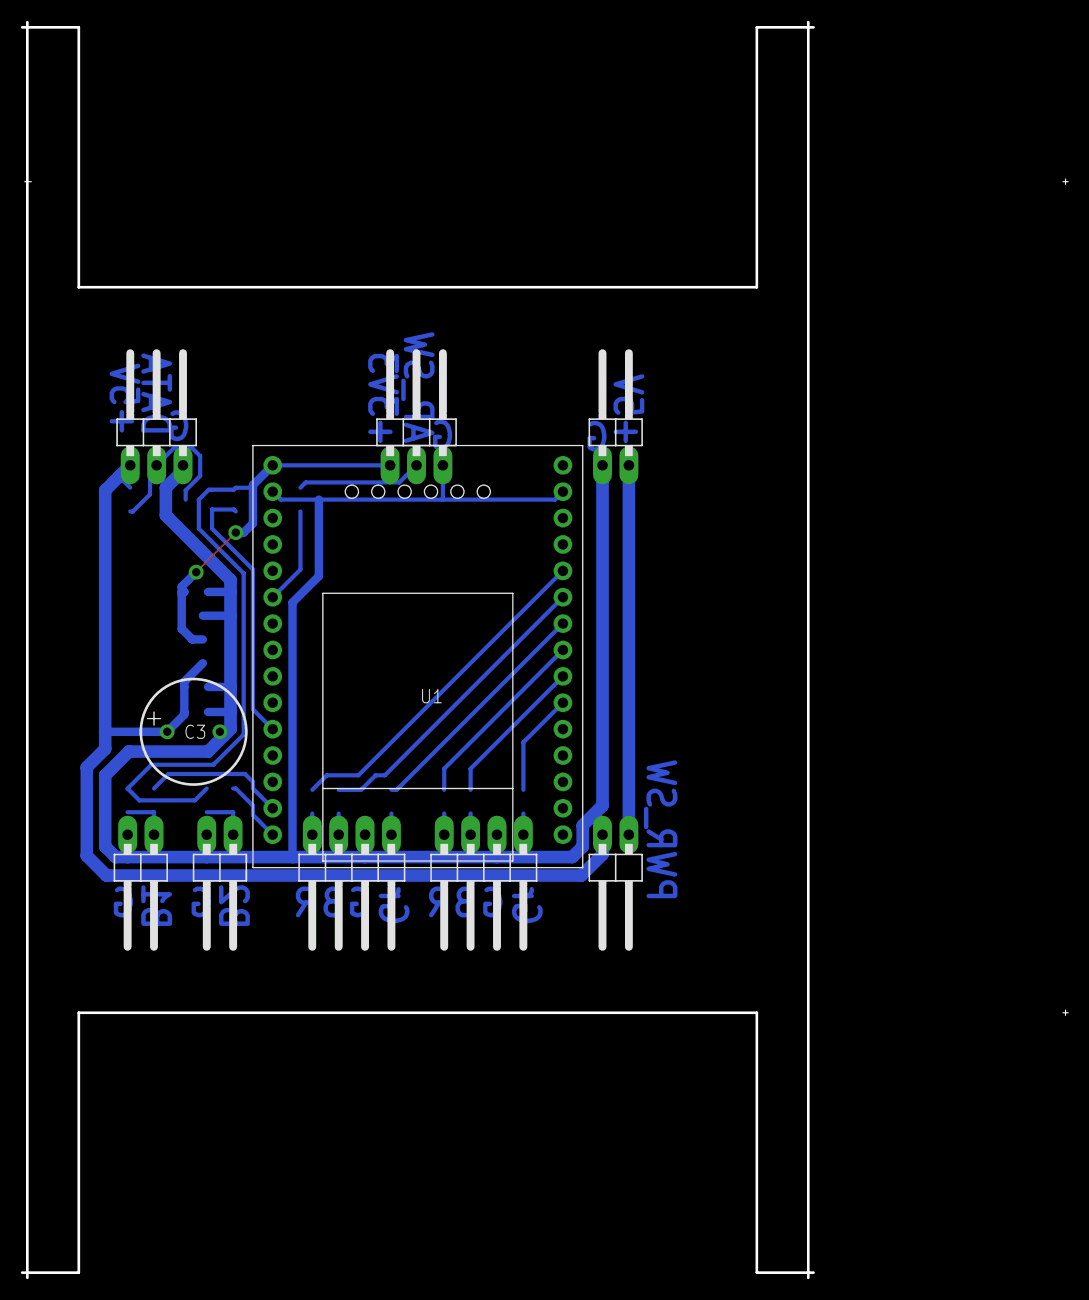
[picture p37: board string_lights_revA.brd from above]

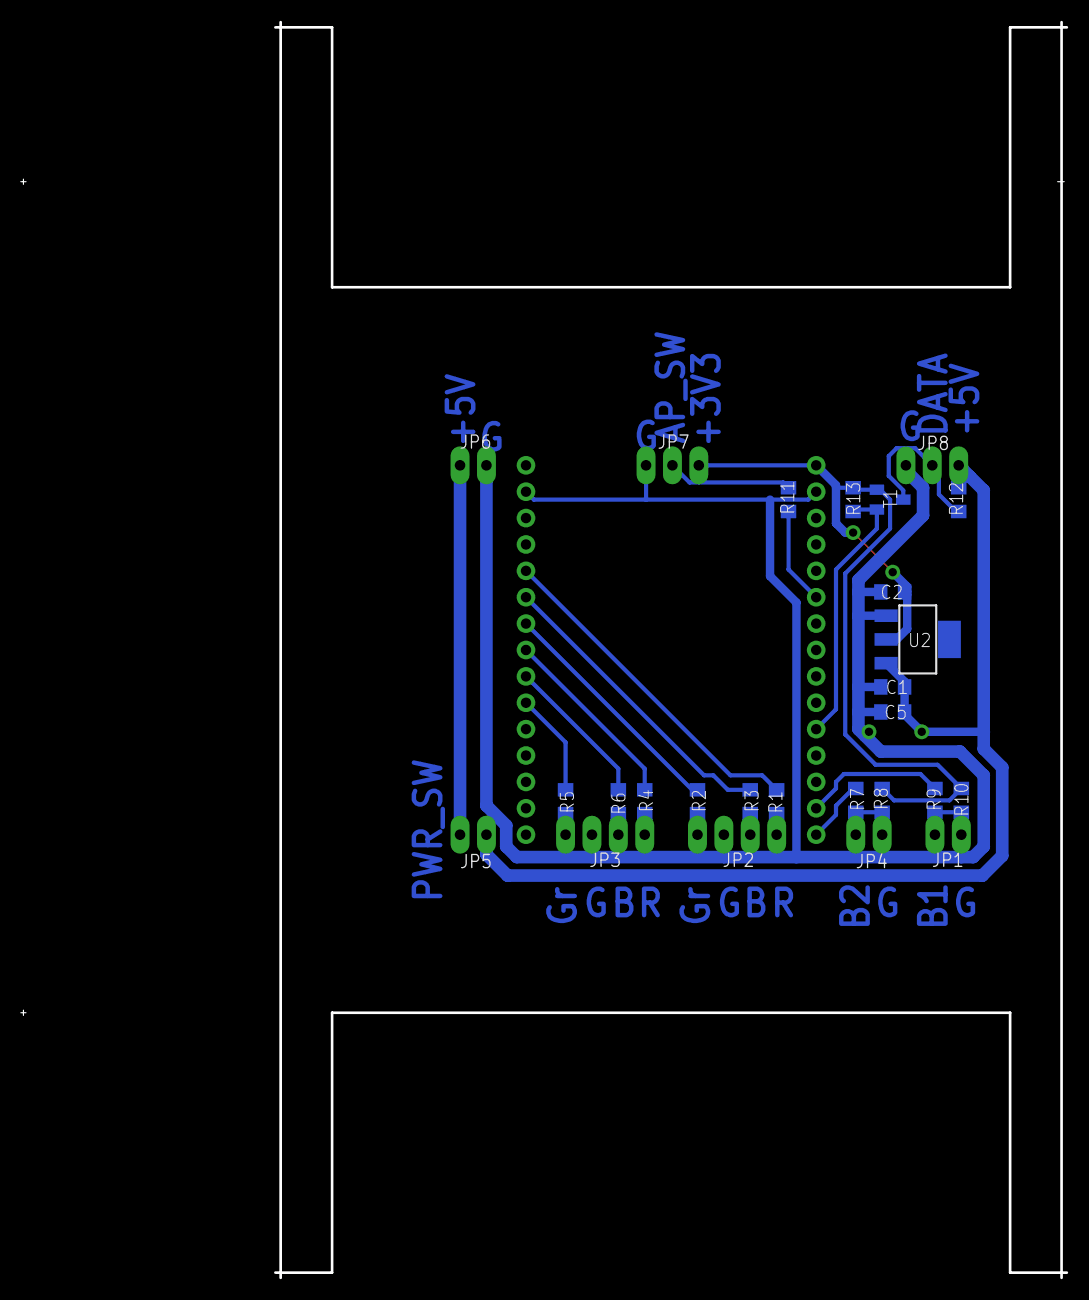
[picture p38: board string_lights_revA.brd from below]

Board: 2 copper layers, 75.2 x 119.9 mm, 28 parts (18 on the bottom side), 24 nets.
