maplac/StringLights/(commit log)

2019-01-20 added: firmware for ESP8266 (Arduino IDE)
2019-02-08 fixed: loading settings from memory
    [StringLights.ino]
2019-02-21 modified: multi color page - buttons for number input
2019-03-01 Firwmare: saving current settings to a file
2019-04-14 Firmware: arduino project splitted into multiple tabs
2019-04-24 Firmware: added LEDs
2019-05-04 Firmware: added HW buttons
2019-05-04 Firmware: fixed sending OK message when error happens
    [a_color_picker.ino, b_single_color.ino, c_multi_color.ino, f_system_settings.ino]
2019-05-05 Firmware: fixed turning on/off the LED strip
    [StringLights.ino, b_single_color.ino, c_multi_color.ino, f_system_settings.ino]
2019-05-05 Firmware: added transparent mode for controling the rbg LEDs without saving to memory
2019-05-05 Firmware: fixed displaying last IP address
    [StringLights.ino, f_system_settings.ino]
2019-09-29 Firmware: switched to ESP32
2019-11-10 Electronics: added revA
    [front_panel_revA.brd, string_lights_revA.brd, string_lights_revA.sch]
2019-12-03 Electronics: finished RevA
    [front_panel_revA.brd, string_lights_revA.brd, string_lights_revA.sch]
2019-12-03 Electronics: added ESP32 adapter
    [ESP32_adapter_revA.brd, ESP32_adapter_revA.sch, ESP32_adapter_revB.brd, ESP32_adapter_revB.sch, ESP32_adapter_revC.brd, ESP32_adapter_revC.sch]
2019-12-03 Electronics: added ESP32 programmer
    [esp32_programmer_revA.brd, esp32_programmer_revA.sch]
2019-12-06 Firmware: multicolor has option to spread colors onto the whole led string
2019-12-11 Firmware: added actions for buttons
2019-12-15 Firmware: changing multi color with HW button skips black slots
    [StringLights.ino, b_single_color.ino, c_multi_color.ino, h_buttons.ino]
2019-12-22 Electronics: added servis connector to the back panel
    [front_panel_revA.brd]
2019-12-22 Firmware: fixed WiFi soft AP
    [StringLights.ino]
